zakqwy/blinktronicator/PCB/blinktronicator.png

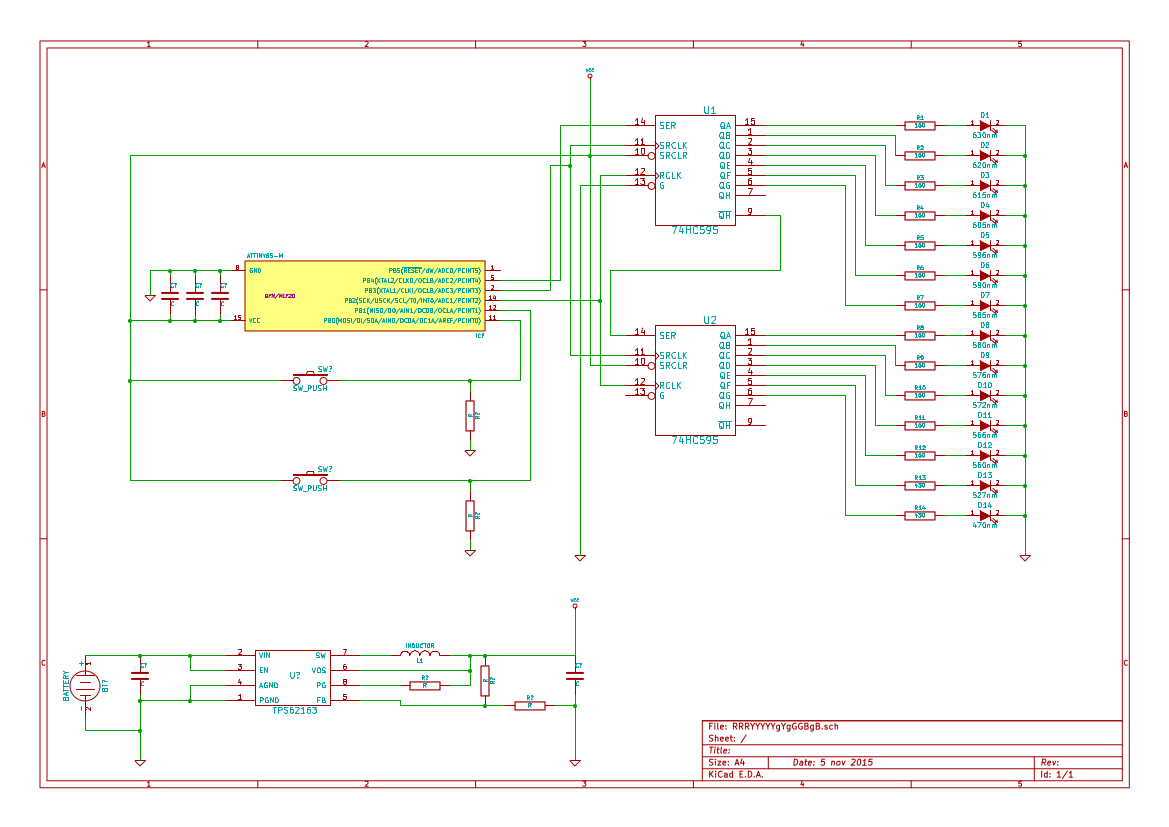
PCB/blinktronicator.png
