zakqwy/blinktronicator/PCB/blinktronicator.pdf

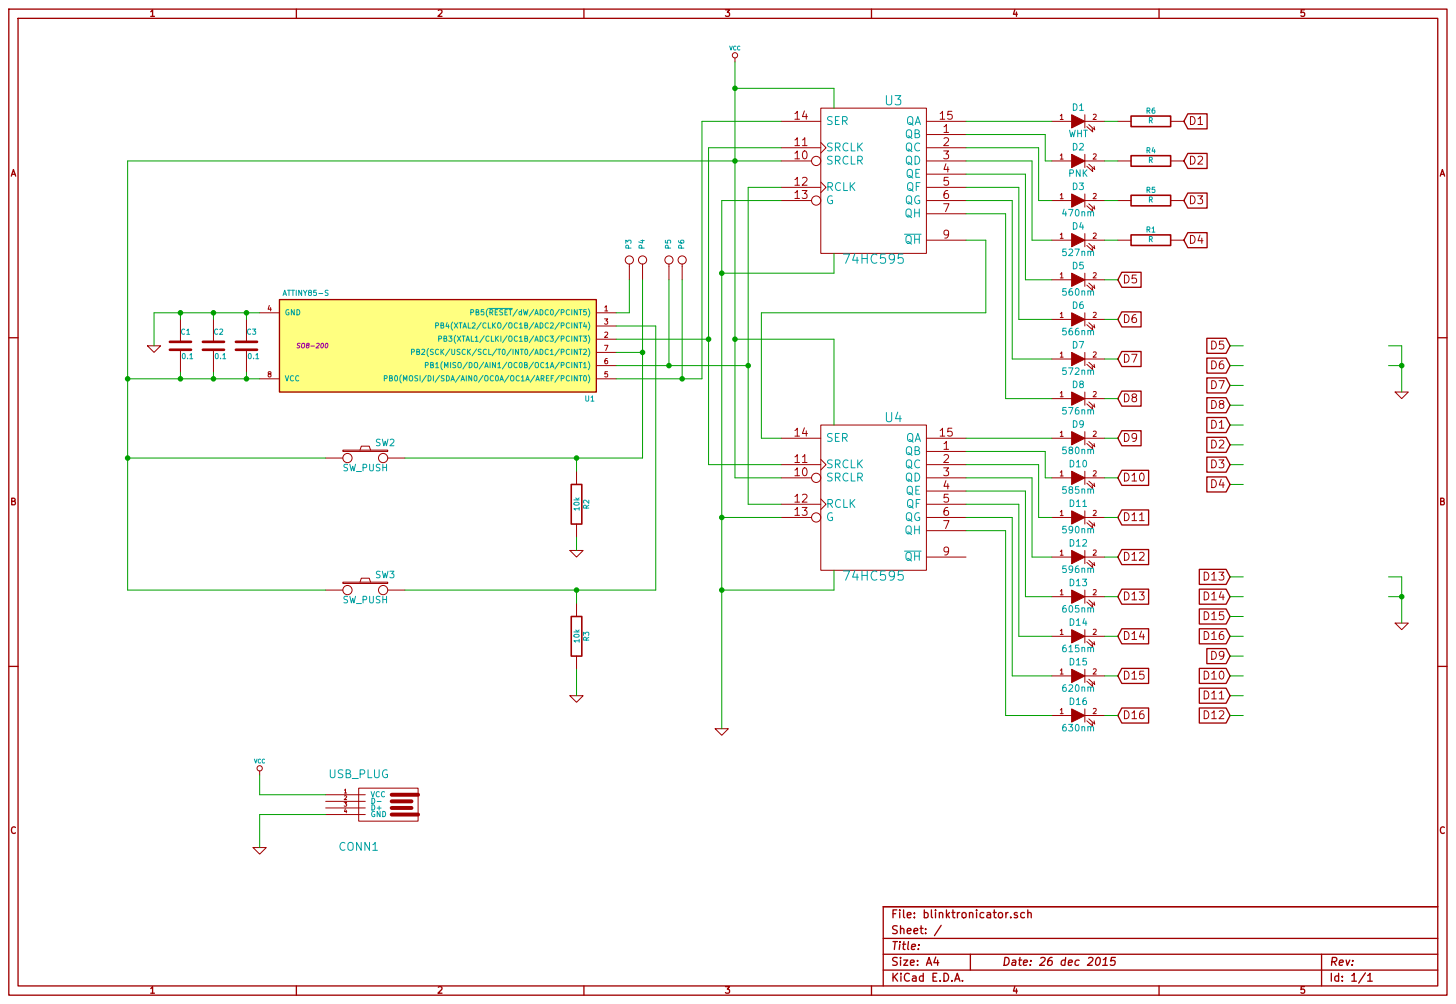
[picture p2: page 1]
