zakqwy/blinktronicator/PCB/blinktronicator.kicad_pcb

## KiCad design PCB/blinktronicator.kicad_pcb (2015-12-31)

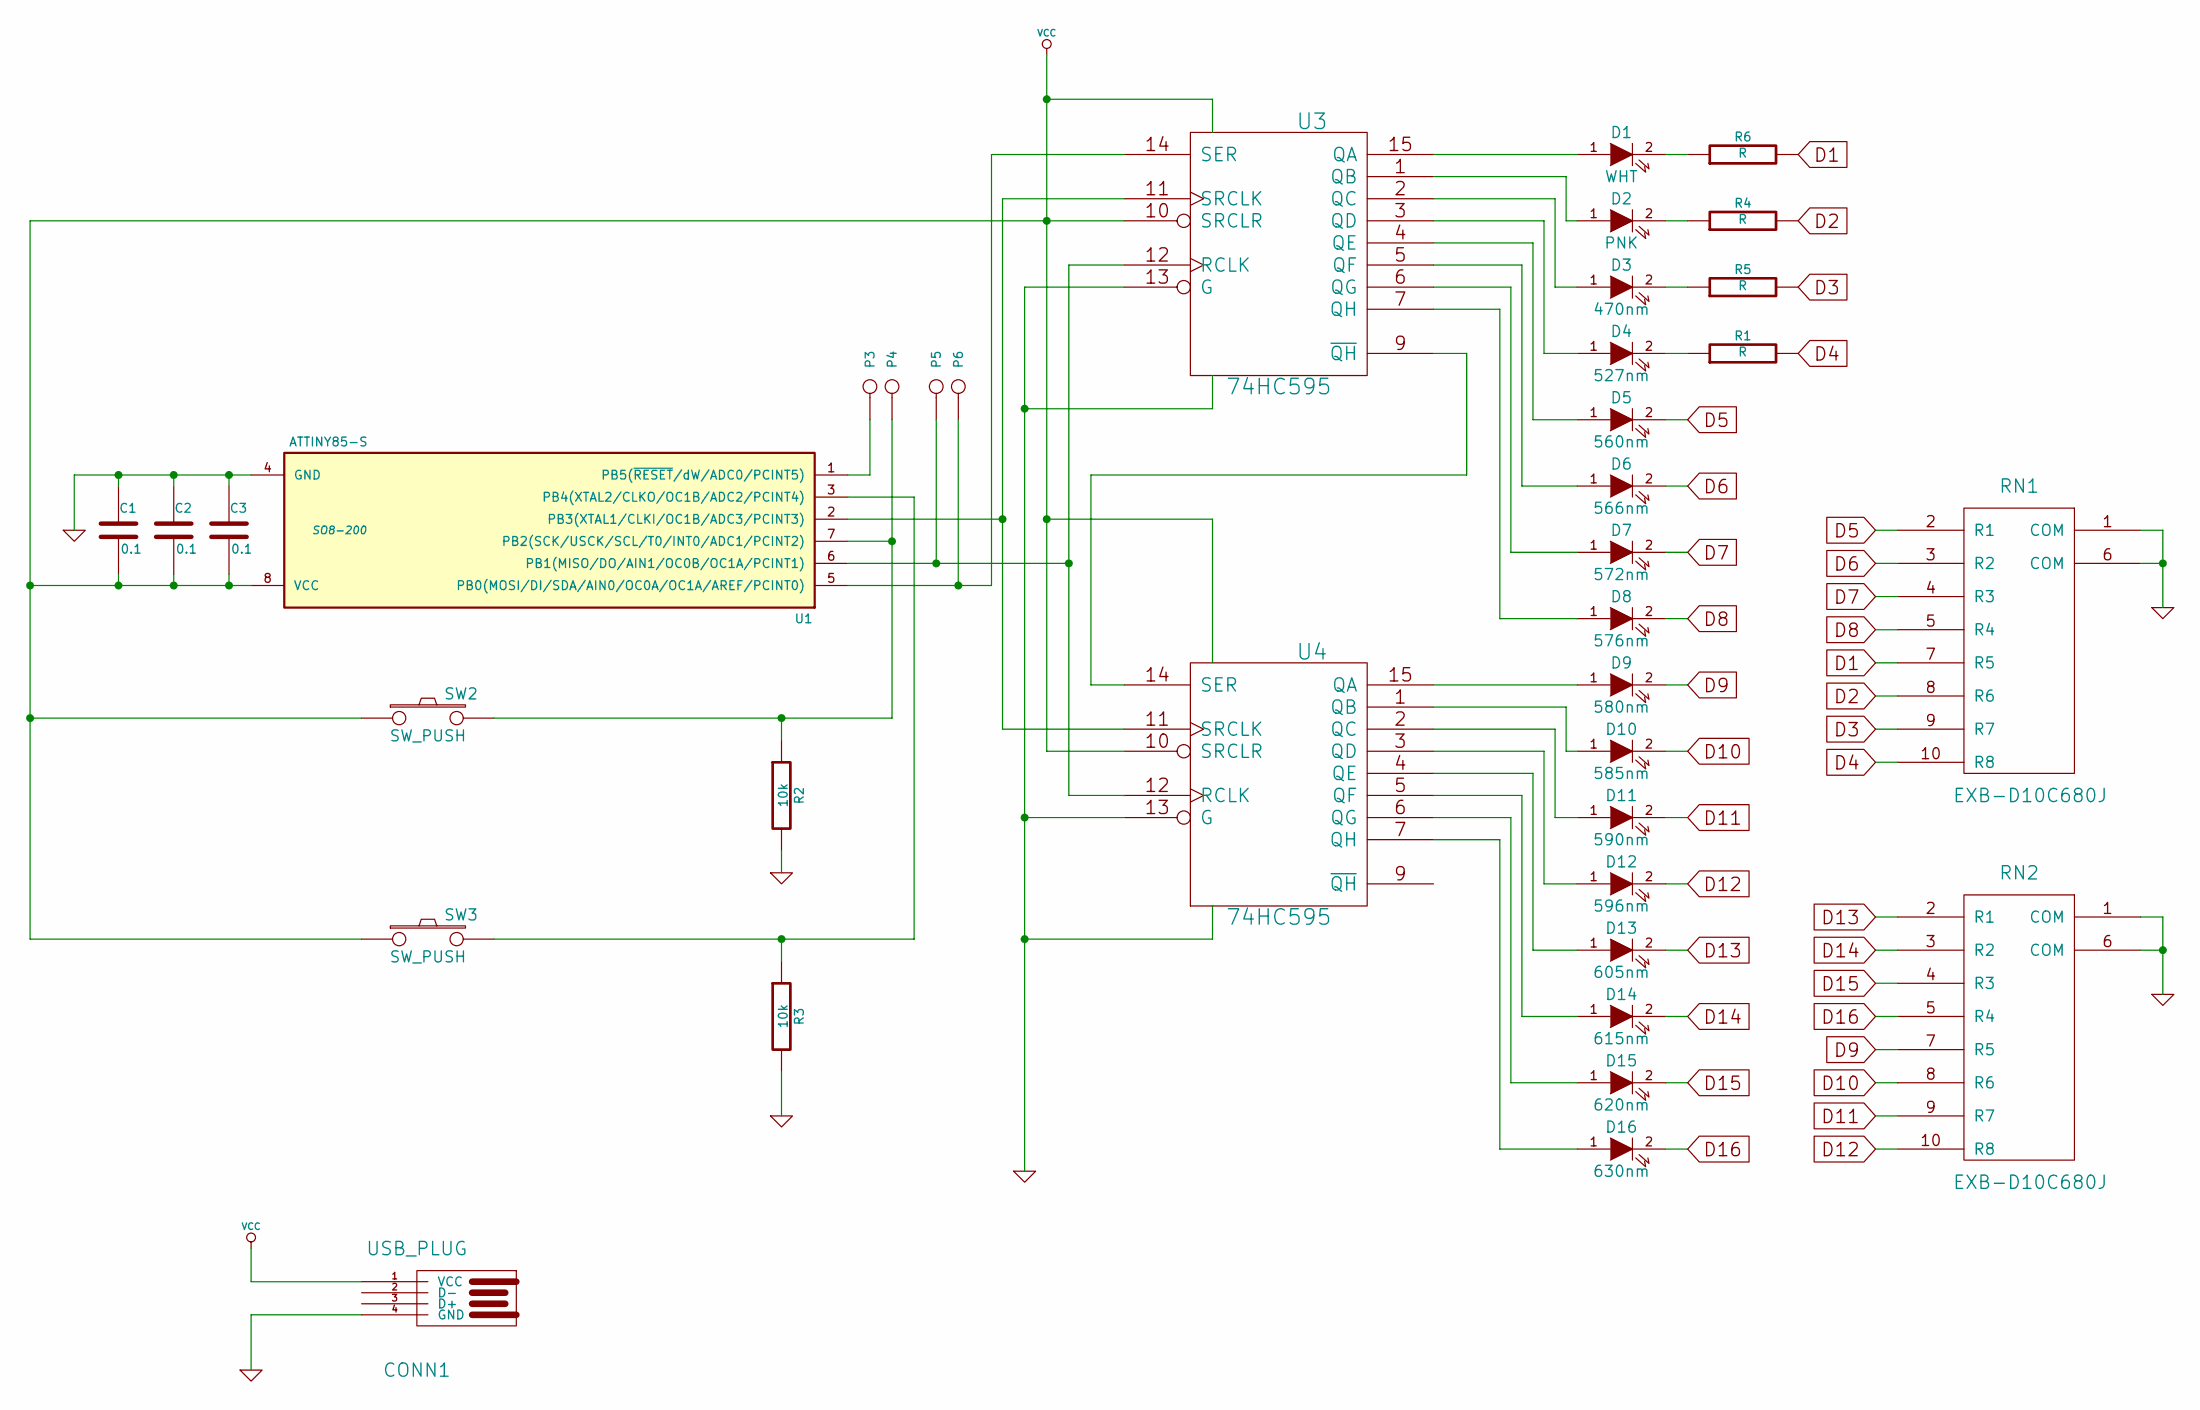
[picture p3: schematic blinktronicator.sch]

Parts:
C1, C2, C3: 0.1
CONN1: USB_PLUG
D1: WHT
D2: PNK
D3: 470nm
D4: 527nm
D5: 560nm
D6: 566nm
D7: 572nm
D8: 576nm
D9: 580nm
D10: 585nm
D11: 590nm
D12: 596nm
D13: 605nm
D14: 615nm
D15: 620nm
D16: 630nm
P3: RST
P4: SCK
P5: MISO
P6: MOSI
R1, R4, R5, R6: R
R2, R3: 10k
RN1, RN2: EXB-D10C680J
SW2, SW3: SW_PUSH
U1: ATTINY85-S; SO8-200
U3, U4: 74HC595

Connections:
D1: R6.2, RN1.7 (R5)
D2: R4.2, RN1.8 (R6)
D3: R5.2, RN1.9 (R7)
D4: R1.2, RN1.10 (R8)
D5: D5.2 (K), RN1.2 (R1)
D6: D6.2 (K), RN1.3 (R2)
D7: D7.2 (K), RN1.4 (R3)
D8: D8.2 (K), RN1.5 (R4)
D9: D9.2 (K), RN2.7 (R5)
D10: D10.2 (K), RN2.8 (R6)
D11: D11.2 (K), RN2.9 (R7)
D12: D12.2 (K), RN2.10 (R8)
D13: D13.2 (K), RN2.2 (R1)
D14: D14.2 (K), RN2.3 (R2)
D15: D15.2 (K), RN2.4 (R3)
D16: D16.2 (K), RN2.5 (R4)
GND: C1.1, C2.1, C3.1, CONN1.4 (GND), R2.2, R3.2, RN1.1 (COM), RN1.6 (COM), RN2.1 (COM), RN2.6 (COM), U1.4 (GND), U3.8 (GND), U3.13 (G), U4.8 (GND), U4.13 (G)
unnamed: D2.1 (A), U3.1 (QB)
unnamed: D1.1 (A), U3.15 (QA)
unnamed: D4.2 (K), R1.1
unnamed: D3.2 (K), R5.1
unnamed: D2.2 (K), R4.1
unnamed: D1.2 (K), R6.1
unnamed: P3.1, U1.1 (PB5(~RESET~/dW/ADC0/PCINT5))
unnamed: D5.1 (A), U3.4 (QE)
unnamed: D8.1 (A), U3.7 (QH)
unnamed: D7.1 (A), U3.6 (QG)
unnamed: D6.1 (A), U3.5 (QF)
unnamed: D4.1 (A), U3.3 (QD)
unnamed: D3.1 (A), U3.2 (QC)
unnamed: P6.1, U1.5 (PB0(MOSI/DI/SDA/AIN0/OC0A/OC1A/AREF/PCI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), U3.14 (SER)
unnamed: U1.2 (PB3(XTAL1/CLKI/OC1B/ADC3/PCINT3)), U3.11 (SRCLK), U4.11 (SRCLK)
unnamed: U3.9 (~QH), U4.14 (SER)
unnamed: P5.1, U1.6 (PB1(MISO/DO/AIN1/OC0B/OC1A/PCINT1)), U3.12 (RCLK), U4.12 (RCLK)
unnamed: D16.1 (A), U4.7 (QH)
unnamed: D15.1 (A), U4.6 (QG)
unnamed: D14.1 (A), U4.5 (QF)
unnamed: D13.1 (A), U4.4 (QE)
unnamed: D9.1 (A), U4.15 (QA)
unnamed: D12.1 (A), U4.3 (QD)
unnamed: D11.1 (A), U4.2 (QC)
unnamed: D10.1 (A), U4.1 (QB)
unnamed: R3.1, SW3.2, U1.3 (PB4(XTAL2/CLKO/OC1B/ADC2/PCINT4))
unnamed: P4.1, R2.1, SW2.2, U1.7 (PB2(SCK/USCK/SCL/T0/INT0/ADC1/PCINT2))
VCC: C1.2, C2.2, C3.2, CONN1.1 (VCC), SW2.1, SW3.1, U1.8 (VCC), U3.10 (SRCLR), U3.16 (VCC), U4.10 (SRCLR), U4.16 (VCC)

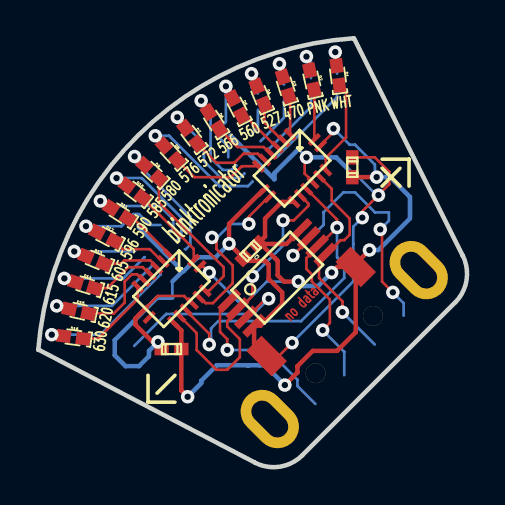
[picture p4: board blinktronicator.kicad_pcb from above]

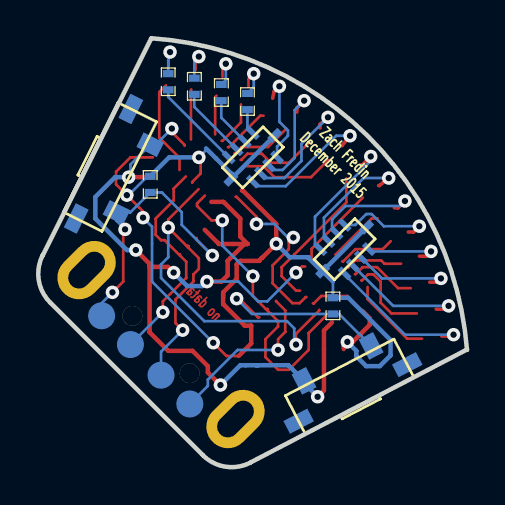
[picture p5: board blinktronicator.kicad_pcb from below]

Board: 2 copper layers, 23.8 x 23.8 mm, 37 parts (14 on the bottom side), 45 nets.
