zakqwy/blinktronicator/PCB/RRRYYYYYgYgGGBgB.kicad_pcb

## KiCad design PCB/RRRYYYYYgYgGGBgB.kicad_pcb (2015-11-09)

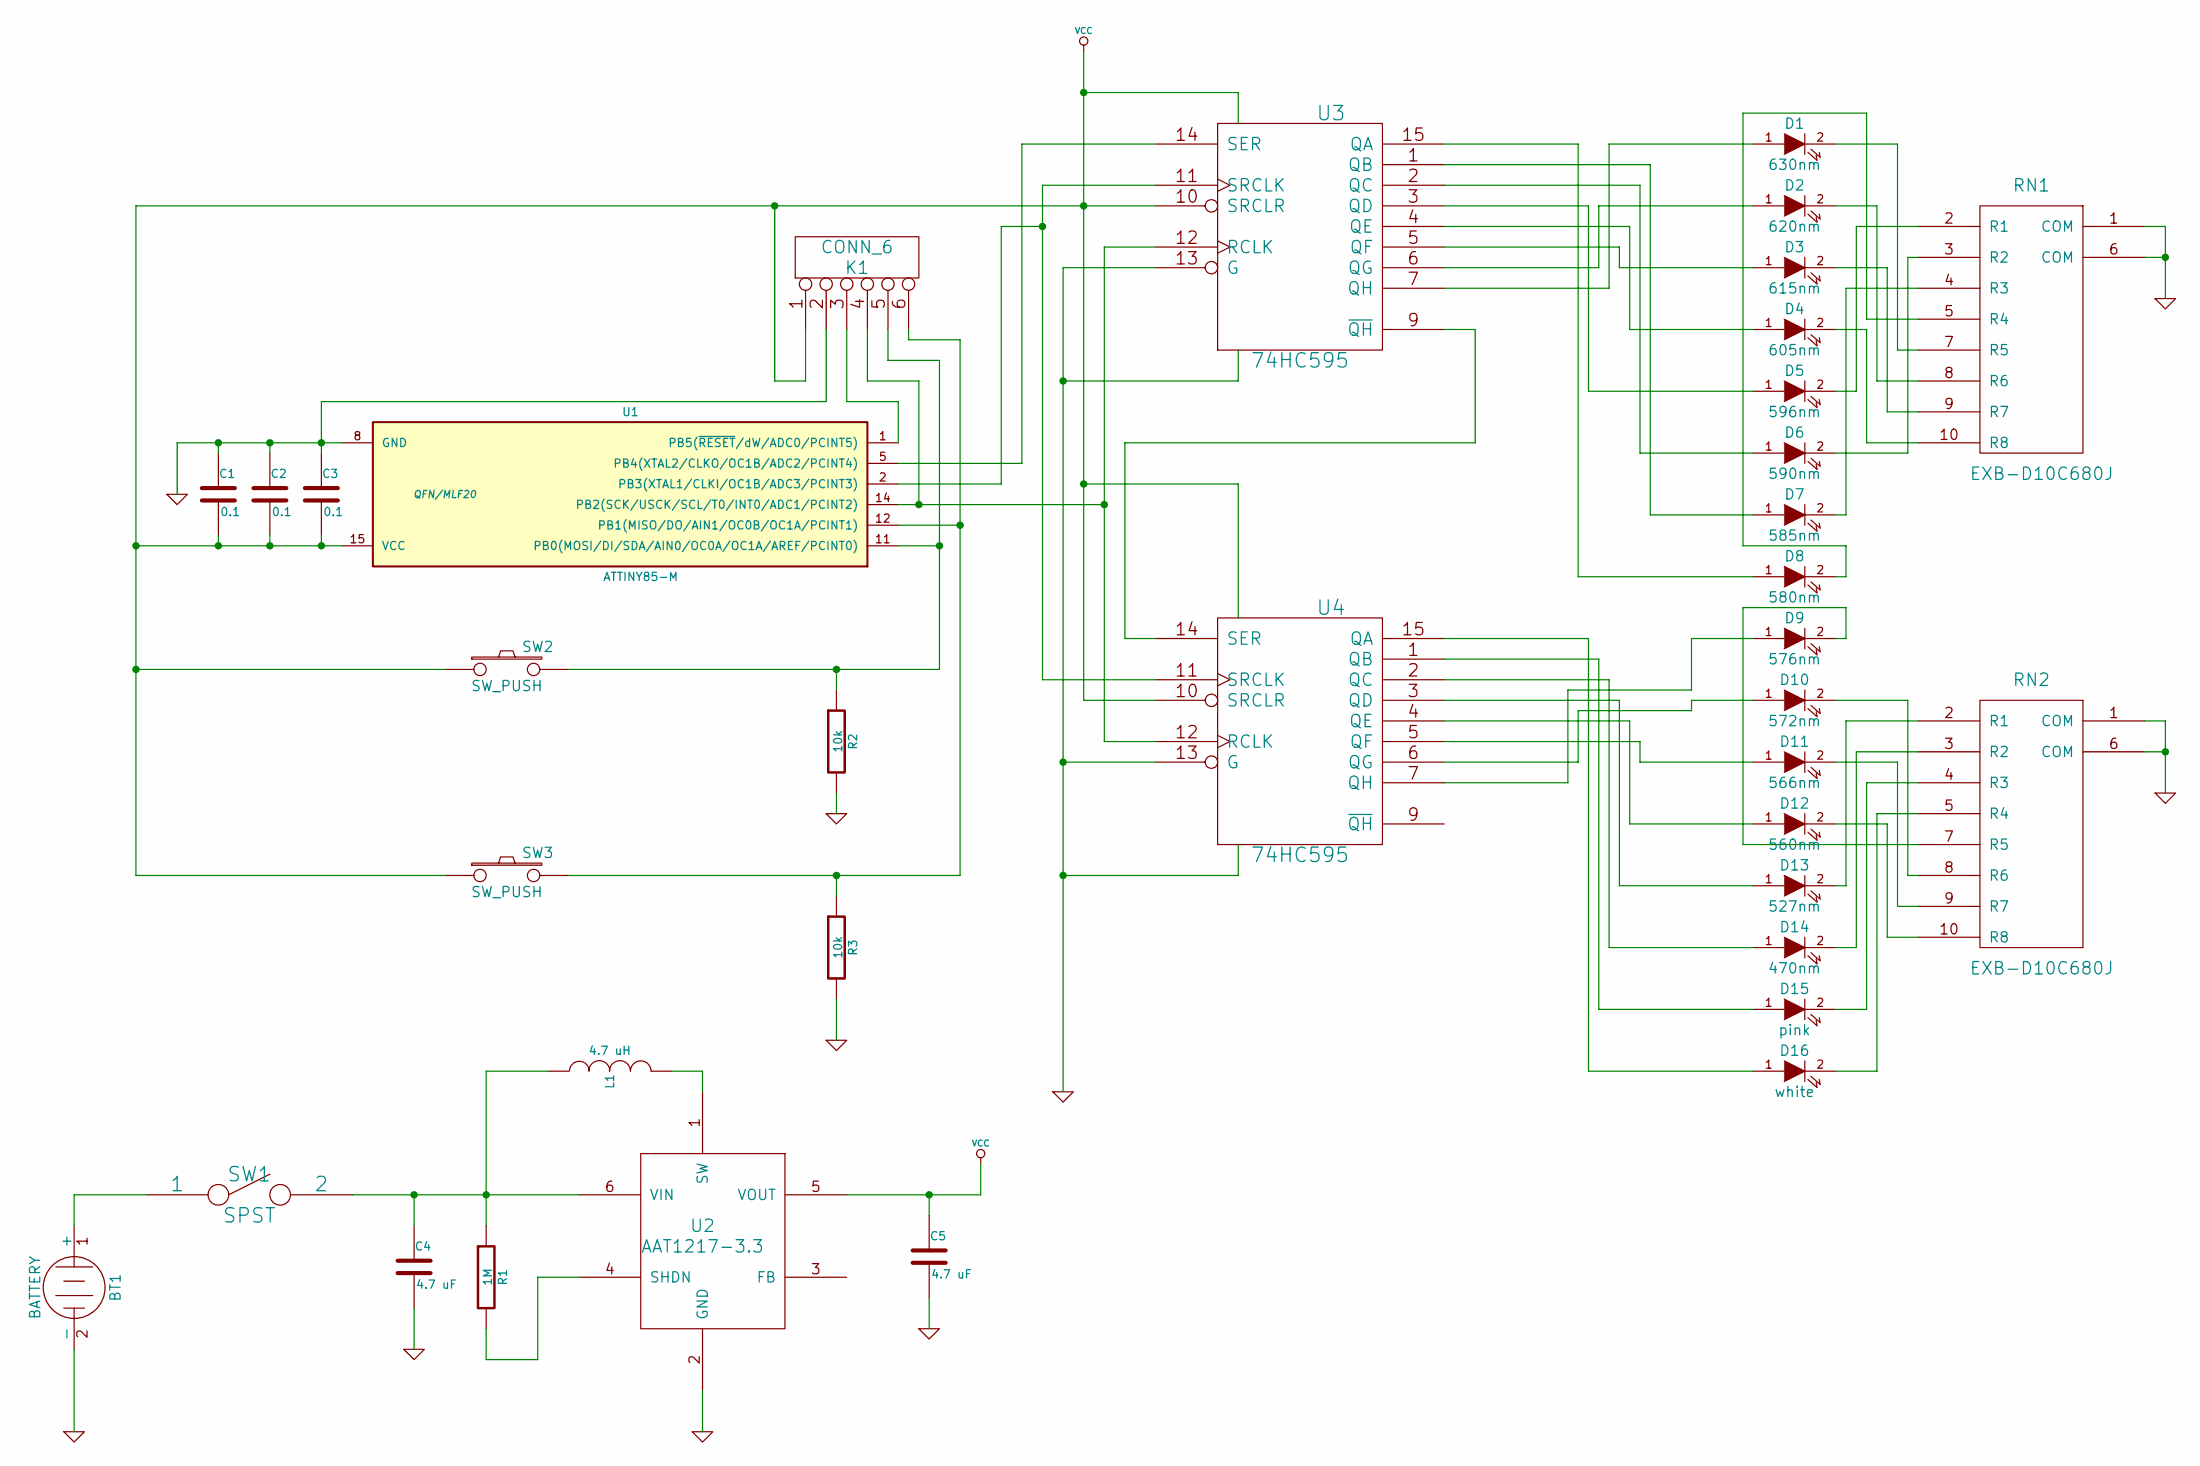
[picture p6: schematic RRRYYYYYgYgGGBgB.sch]

Parts:
BT1: BATTERY
C1, C2, C3: 0.1
C4, C5: 4.7 uF
D1: 630nm
D2: 620nm
D3: 615nm
D4: 605nm
D5: 596nm
D6: 590nm
D7: 585nm
D8: 580nm
D9: 576nm
D10: 572nm
D11: 566nm
D12: 560nm
D13: 527nm
D14: 470nm
D15: pink
D16: white
K1: CONN_6
L1: 4.7 uH
R1: 1M
R2, R3: 10k
RN1, RN2: EXB-D10C680J
SW1: SPST
SW2, SW3: SW_PUSH
U1: ATTINY85-M; QFN/MLF20
U2: AAT1217-3.3
U3, U4: 74HC595

Connections:
GND: BT1.2 (-), C1.1, C2.1, C3.1, C4.2, C5.2, K1.2, R2.2, R3.2, RN1.1 (COM), RN1.6 (COM), RN2.1 (COM), RN2.6 (COM), U1.8 (GND), U2.2 (GND), U3.8 (GND), U3.13 (G), U4.8 (GND), U4.13 (G)
unnamed: K1.3, U1.1 (PB5(~RESET~/dW/ADC0/PCINT5))
unnamed: K1.6, R3.1, SW3.2, U1.12 (PB1(MISO/DO/AIN1/OC0B/OC1A/PCINT1))
unnamed: K1.5, R2.1, SW2.2, U1.11 (PB0(MOSI/DI/SDA/AIN0/OC0A/OC1A/AREF/PCI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)
unnamed: D2.2 (K), RN1.8 (R6)
unnamed: BT1.1 (+), SW1.1
unnamed: D4.2 (K), RN1.10 (R8)
unnamed: D3.2 (K), RN1.9 (R7)
unnamed: D1.2 (K), RN1.7 (R5)
unnamed: D5.2 (K), RN1.2 (R1)
unnamed: D6.2 (K), RN1.3 (R2)
unnamed: L1.2, U2.1 (SW)
unnamed: C4.1, L1.1, R1.1, SW1.2, U2.6 (VIN)
unnamed: R1.2, U2.4 (SHDN)
unnamed: D6.1 (A), U3.2 (QC)
unnamed: D15.1 (A), U4.1 (QB)
unnamed: D16.1 (A), U4.15 (QA)
unnamed: D8.1 (A), U3.15 (QA)
unnamed: D7.1 (A), U3.1 (QB)
unnamed: D5.1 (A), U3.3 (QD)
unnamed: D4.1 (A), U3.4 (QE)
unnamed: D3.1 (A), U3.5 (QF)
unnamed: D2.1 (A), U3.6 (QG)
unnamed: D11.1 (A), U4.5 (QF)
unnamed: D9.1 (A), U4.7 (QH)
unnamed: D10.1 (A), U4.6 (QG)
unnamed: D12.1 (A), U4.4 (QE)
unnamed: D13.1 (A), U4.3 (QD)
unnamed: D14.1 (A), U4.2 (QC)
unnamed: U1.5 (PB4(XTAL2/CLKO/OC1B/ADC2/PCINT4)), U3.14 (SER)
unnamed: D1.1 (A), U3.7 (QH)
unnamed: U3.9 (~QH), U4.14 (SER)
unnamed: K1.4, U1.14 (PB2(SCK/USCK/SCL/T0/INT0/ADC1/PCINT2)), U3.12 (RCLK), U4.12 (RCLK)
unnamed: U1.2 (PB3(XTAL1/CLKI/OC1B/ADC3/PCINT3)), U3.11 (SRCLK), U4.11 (SRCLK)
unnamed: D7.2 (K), RN1.4 (R3)
unnamed: D11.2 (K), RN2.9 (R7)
unnamed: D10.2 (K), RN2.8 (R6)
unnamed: D9.2 (K), RN2.7 (R5)
unnamed: D12.2 (K), RN2.10 (R8)
unnamed: D15.2 (K), RN2.4 (R3)
unnamed: D8.2 (K), RN1.5 (R4)
unnamed: D16.2 (K), RN2.5 (R4)
unnamed: D14.2 (K), RN2.3 (R2)
unnamed: D13.2 (K), RN2.2 (R1)
VCC: C1.2, C2.2, C3.2, C5.1, K1.1, SW2.1, SW3.1, U1.15 (VCC), U2.5 (VOUT), U3.10 (SRCLR), U3.16 (VCC), U4.10 (SRCLR), U4.16 (VCC)

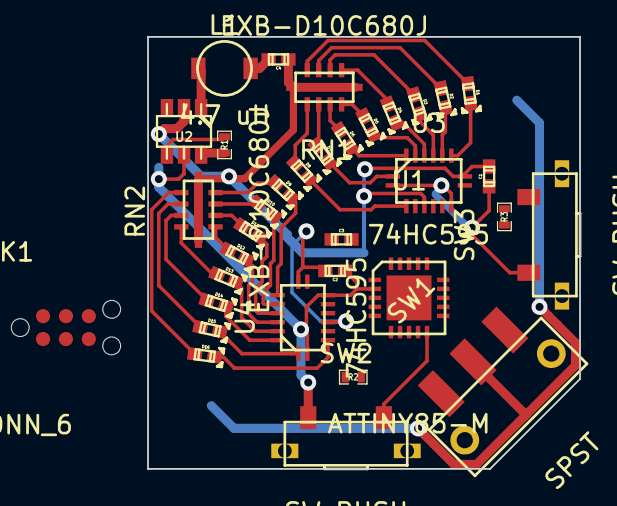
[picture p7: board RRRYYYYYgYgGGBgB.kicad_pcb from above]

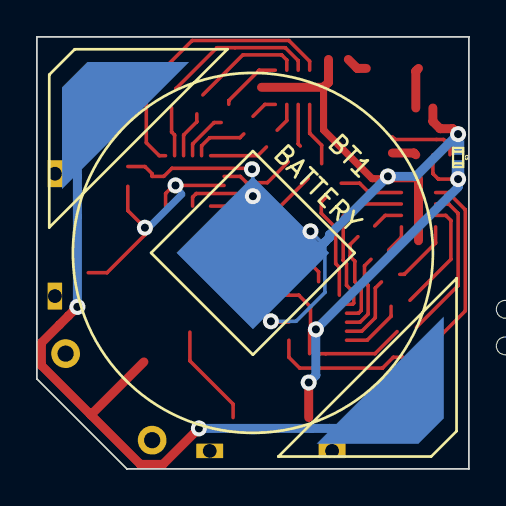
[picture p8: board RRRYYYYYgYgGGBgB.kicad_pcb from below]

Board: 2 copper layers, 24.0 x 24.0 mm, 36 parts (2 on the bottom side), 44 nets.
