zakqwy/blinktronicator/(threads)

Thread 1 (2017-10-15):

74HC595BQ 16-DHVQFN (2.5x3.5)

dunk8888, 2017-10-15:
Hi,Great project! Ime in the process of making this project. Just a question regards to the 74hC595BQ.
I can only find the package for this in this size 2.6x3.6.
Will this be much of a problem,will this fit with a squeeze do you think?
Thanks

zakqwy, 2017-10-15:
Glad you're building one! 2.6x3.6 shouldn't be a problem; I stretched the pads a bit for ease of hand soldering so that will fit. I'm guessing it's actually the same part, if I recall the 2.5x3.5 was a nominal dimension. Good luck, let me know if you have any issues with the build.

dunk8888, 2017-10-15:
Oh right ok,i did see the pads where quite long,i`me very good at soldering and i enjoy it. I find it kind of therapeutic so that side of things should be ok.
Sourcing the leds will be a pain for me i think,although i could use alternatives as it doesnt have to be spot on for me.I just enjoy the build.
Thanks for getting back to me so quickly i can get on now with ordering the parts.
Duncan

dunk8888, 2017-10-15:
This will be ok will it?

http://www.ebay.co.uk/itm/5PCS-74HC595BQ-115-IC-8BIT-SHIFT-REGISTER-16-DHVQFN-74HC595BQ-HC595-74HC595-/192143311090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

zakqwy, 2017-10-15:
yup, those shift registers look good. and any 0402 LEDs should fit; the PicoLEDs just have enough different colors to provide a neat effect.

dunk8888, 2017-10-15:
In fact this is the one ile get its quicker postage.
http://uk.rs-online.com/web/p/counters-shift-registers/7918753/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

dunk8888, 2017-10-15:
I will try get the picoLEDs if i can source them around my end,digikey could be quite costly,with £10 postage to start with ive not looked properly yet,ile let you know how i get on. thanks

Closed 2017-10-15.

Thread 2 (2017-10-15):

Leds?

dunk8888, 2017-10-15:
Hi,do all the led gnd go through a resistor to gnd? ime trying a breadboard version now?
Also do you have a schematic with the resistor part showing? Thanks

zakqwy, 2017-10-15:
yup, each LED has its own resistor. value depends on the LED (vdrop and current draw).

zakqwy, 2017-10-15:
to clarify, the LEDs go through resistor networks to save space, then a few of em go through another resistor to further limit current.

dunk8888, 2017-10-16:
Yes ive got it running now,its great,ive even just finished my own pcb
version,its a bit bigger than yours and uses bigger shift registers,i have
loads from a few years ago and ive been wanting to use them so ime using
them with this project,i knew they would come in handy.

The pcb ive designed is just rough at minute ive not decided yet on the
final design.Ime going to make one for standard through hole leds too.

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

zakqwy, 2017-10-16:
awesome!! Thanks for posting this -- if you snap any photos, link to em here so I can take a look. would be neat to see another blinktronicator in the wild.

Closed 2019-03-19.
