zakqwy/blinktronicator/(commit log)

2015-11-06 Changed from buck to boost converter for 3vdc power. Added values and designators for various components. Generated a netlist. More changes (likely) to come.
    [RRRYYYYYgYgGGBgB.sch]
2015-11-08 added pink and white LEDs. started pcb layout. LEDs arranged in an ~80 degree arc. schematic changed around a bit to make routing a tiny bit easier. note: schematic (specifically around shift registe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
    [RRRYYYYYgYgGGBgB.kicad_pcb, RRRYYYYYgYgGGBgB.sch]
2015-11-09 moved a bunch of traces around and slightly reduced the rats nest.
    [RRRYYYYYgYgGGBgB.kicad_pcb]
2015-11-10 changed the file names to reflect addition of pink and white LEDs. finished routing, beefed up power rails, rounded corners. changed processor footprint to TSSOP. still needs a thorough review...
    [RRROYYYYgYgGGBgBPW.kicad_pcb, RRROYYYYgYgGGBgBPW.sch]
2015-12-08 changed from 3.3vdc boost converter + 2032 coin cell to usb plug power. added silkscreen, re-routed, etc. resistor network value still TBD, i'm afraid (it worked at 3.3vdc, but might not here...)
    [RRROYYYYgYgGGBgBPW-B_Cu.gbl, RRROYYYYgYgGGBgBPW-B_Mask.gbs, RRROYYYYgYgGGBgBPW-B_SilkS.gbo, RRROYYYYgYgGGBgBPW-Edge_Cuts.gbr, RRROYYYYgYgGGBgBPW-F_Cu.gtl, RRROYYYYgYgGGBgBPW-F_Mask.gts, RRROYYYYgYgGGBgBPW-F_SilkS.gto, RRROYYYYgYgGGBgBPW.drl]
2015-12-08 realized the resistor networks were sized for 3.3vdc power; moving to 5vdc power means the shorter wavelength stuff needs a different value. bodged in a quartet of 0402 resistors, mounted on the back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
    [RRROYYYYgYgGGBgBPW-B_Cu.gbl, RRROYYYYgYgGGBgBPW-B_Mask.gbs, RRROYYYYgYgGGBgBPW-B_SilkS.gbo, RRROYYYYgYgGGBgBPW-Edge_Cuts.gbr, RRROYYYYgYgGGBgBPW-F_Cu.gtl, RRROYYYYgYgGGBgBPW-F_Mask.gts, RRROYYYYgYgGGBgBPW-F_SilkS.gto, RRROYYYYgYgGGBgBPW.drl]
2015-12-08 removed a few reference marks
    [RRROYYYYgYgGGBgBPW-B_Cu.gbl, RRROYYYYgYgGGBgBPW-B_Mask.gbs, RRROYYYYgYgGGBgBPW-B_SilkS.gbo, RRROYYYYgYgGGBgBPW-Edge_Cuts.gbr, RRROYYYYgYgGGBgBPW-F_Cu.gtl, RRROYYYYgYgGGBgBPW-F_Mask.gts, RRROYYYYgYgGGBgBPW-F_SilkS.gto, RRROYYYYgYgGGBgBPW.drl]
2015-12-28 many changes. formal name change from "RRRROOOGG..etc" to "blinktronicator". got basic functions working (led update function, mostly). updated PCB to eliminate stupid errors--mirror image shift regi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
    [RRROYYYYgYgGGBgBPW-B_Cu.gbl, RRROYYYYgYgGGBgBPW-B_Mask.gbs, RRROYYYYgYgGGBgBPW-B_SilkS.gbo, RRROYYYYgYgGGBgBPW-Edge_Cuts.gbr, RRROYYYYgYgGGBgBPW-F_Cu.gtl, RRROYYYYgYgGGBgBPW-F_Mask.gts, RRROYYYYgYgGGBgBPW-F_SilkS.gto, RRROYYYYgYgGGBgBPW.drl]
2015-12-31 Several minor PCB updates (slots for USB connector, changed silkscreen, etc).
    [.kicad_pcb.kicad_pcb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]
2016-01-02 Added a PWM fading function along with some demo code.
2016-06-12 Broke program into three groups: a simple PWM fading routine, the old runtime program, and the new version with four operating modes. FIRMWARE/runtime is now the standard blinktronicator program.
    [main.c]
